andrewrussellmalcolm/LEDClock/hardware/label.png

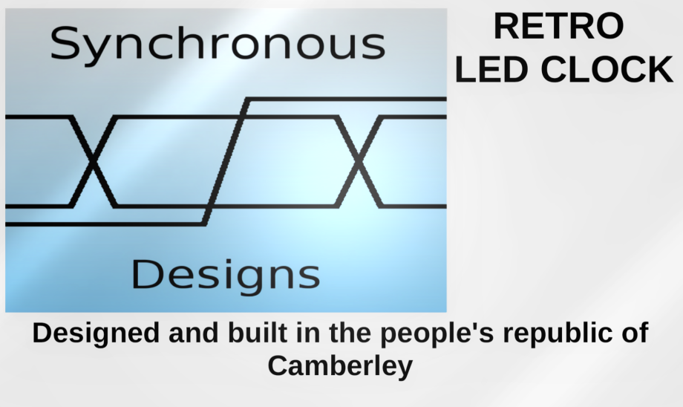
hardware/label.png
