andrewrussellmalcolm/LEDClock/hardware/article/rear-view.png

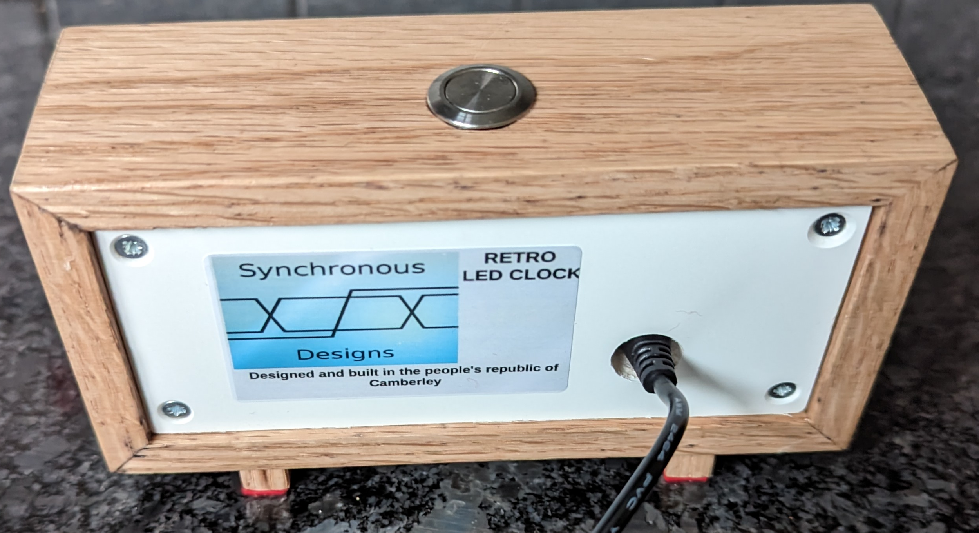
hardware/article/rear-view.png
