andrewrussellmalcolm/LEDClock/hardware/product label.odt

Label Planet LP21/63 | | Label Planet LP21/63 | | Label Planet LP21/63
Label Planet LP21/63 | | Label Planet LP21/63 | | Label Planet LP21/63
Label Planet LP21/63 | | Label Planet LP21/63 | | Label Planet LP21/63
Label Planet LP21/63 | | Label Planet LP21/63 | | Label Planet LP21/63
Label Planet LP21/63 | | Label Planet LP21/63 | | Label Planet LP21/63
Label Planet LP21/63 | | Label Planet LP21/63 | | Label Planet LP21/63
Label Planet LP21/63 | | Label Planet LP21/63 | | Label Planet LP21/63
