andrewrussellmalcolm/LEDClock/hardware/article/3D_model.png

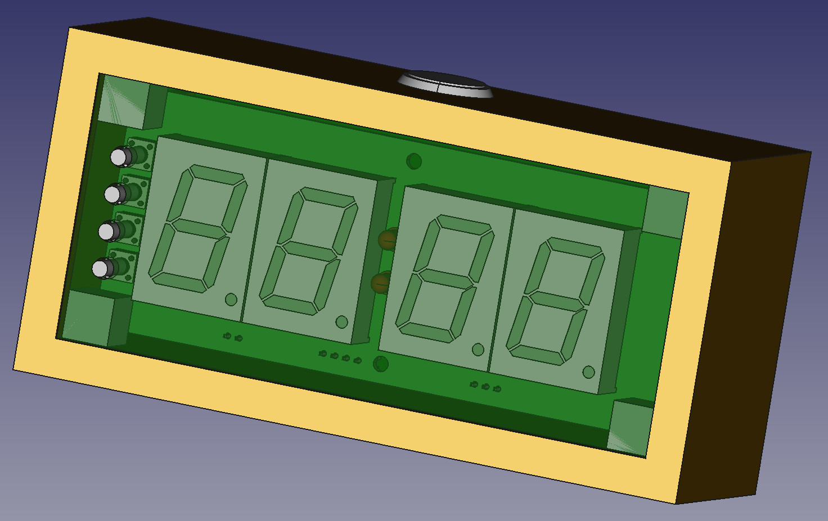
hardware/article/3D_model.png
