andrewrussellmalcolm/LEDClock/hardware/article/front-view.png

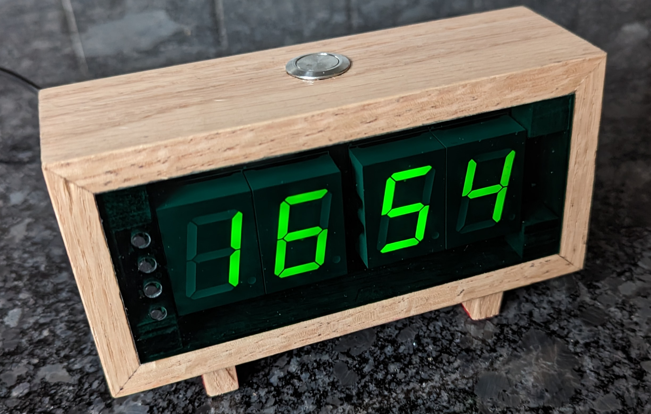
hardware/article/front-view.png
