andrewrussellmalcolm/LEDClock/hardware/article/microcontroller configuration.png

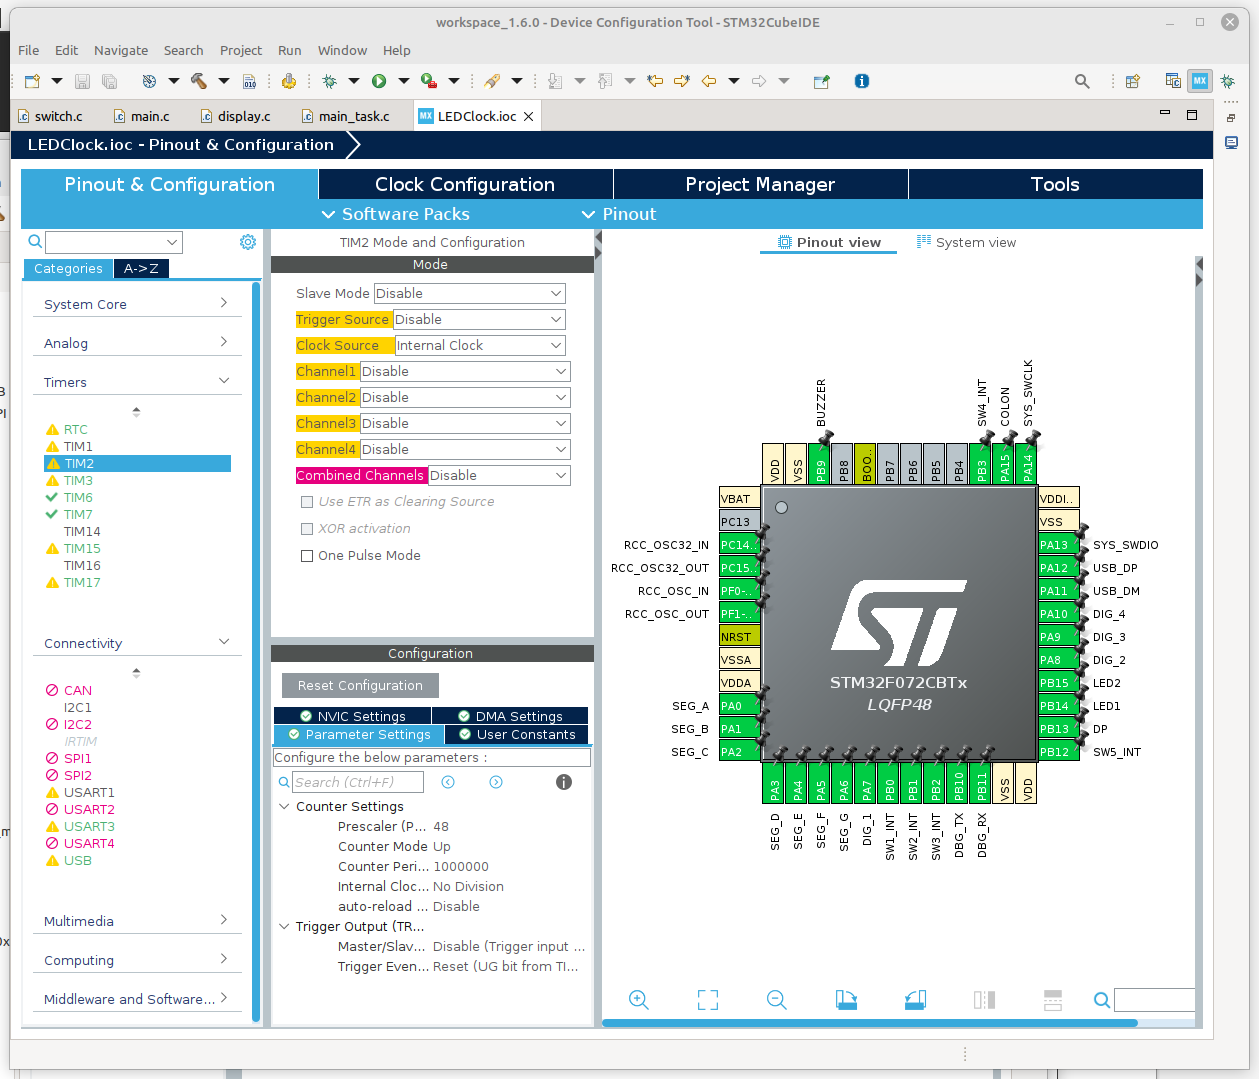
hardware/article/microcontroller configuration.png
