andrewrussellmalcolm/LEDClock/hardware/article/schematic.png

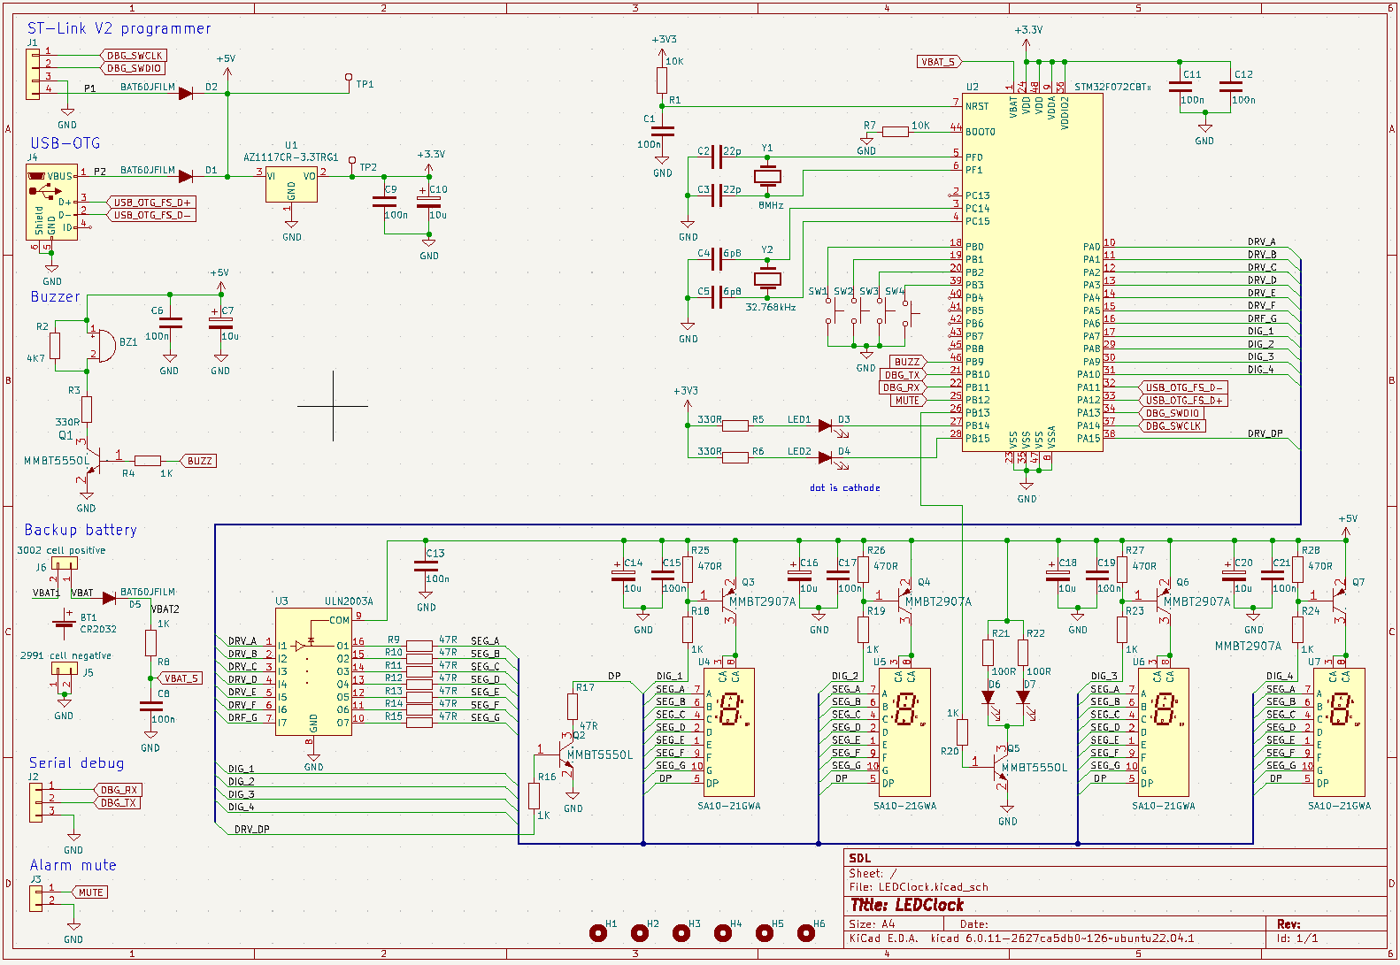
hardware/article/schematic.png
