andrewrussellmalcolm/LEDClock/hardware/LEDClock.jpg

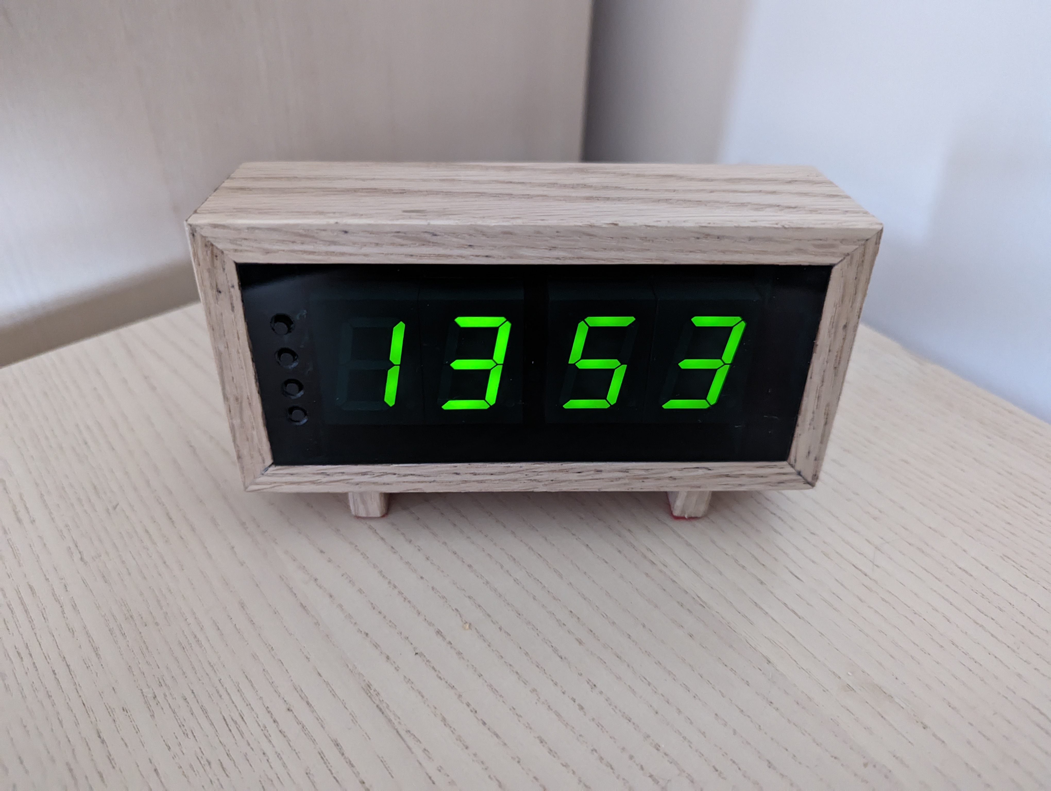
hardware/LEDClock.jpg
