andrewrussellmalcolm/LEDClock/hardware/3D_models/User Library-PKLCS1212E2XXX.STEP

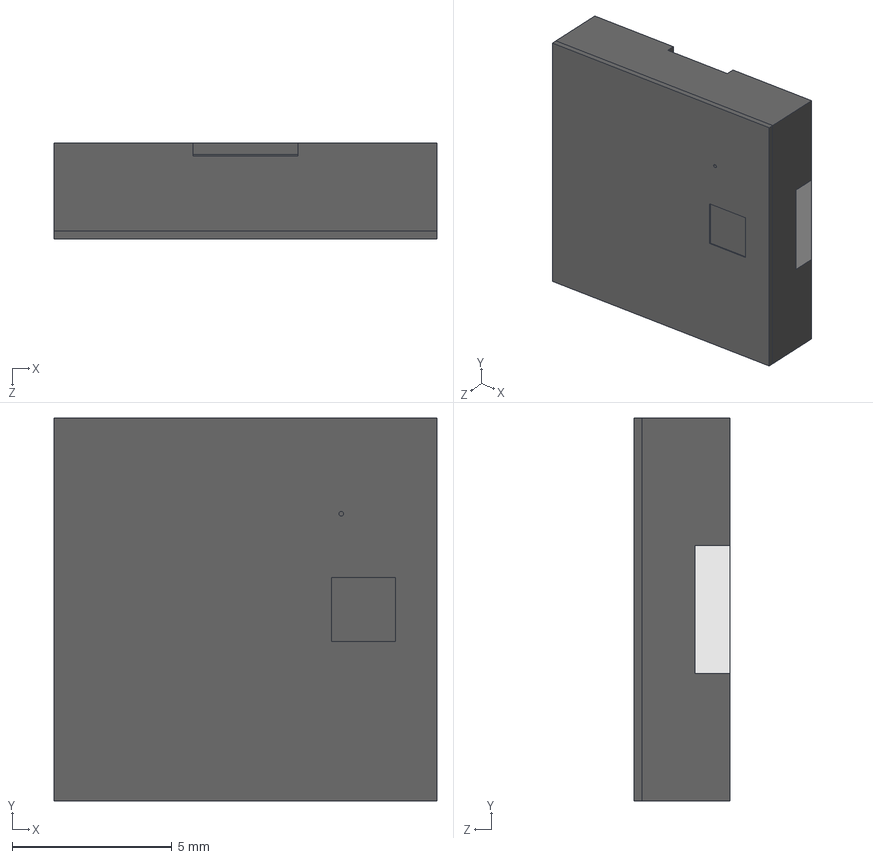
[picture p8: CAD file, 2024-01-20]
hardware/3D_models/User Library-PKLCS1212E2XXX.STEP
12.0 x 12.0 x 3.00 mm
