andrewrussellmalcolm/LEDClock/hardware/3D_models/SA10-21.STEP

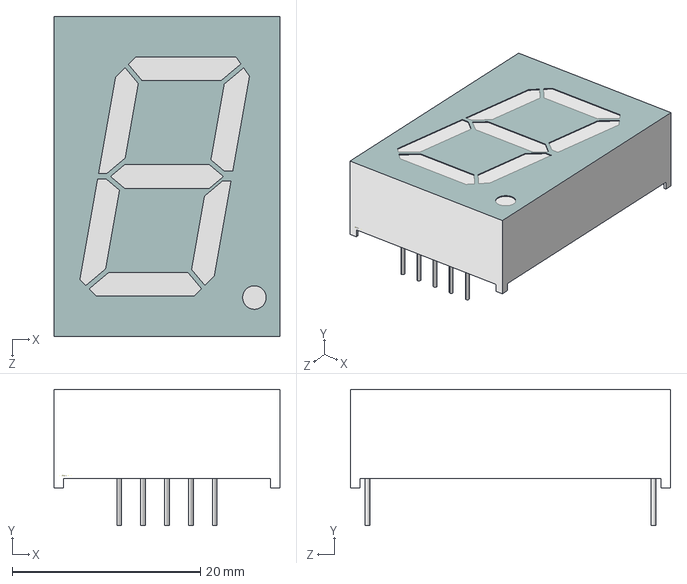
[picture p9: CAD file, 2024-01-20]
hardware/3D_models/SA10-21.STEP
24.0 x 14.5 x 34.0 mm
