andrewrussellmalcolm/LEDClock/hardware/3D_models/User Library-KEYSTONE_2991_Coin_cell_sm_negative_contact.STEP

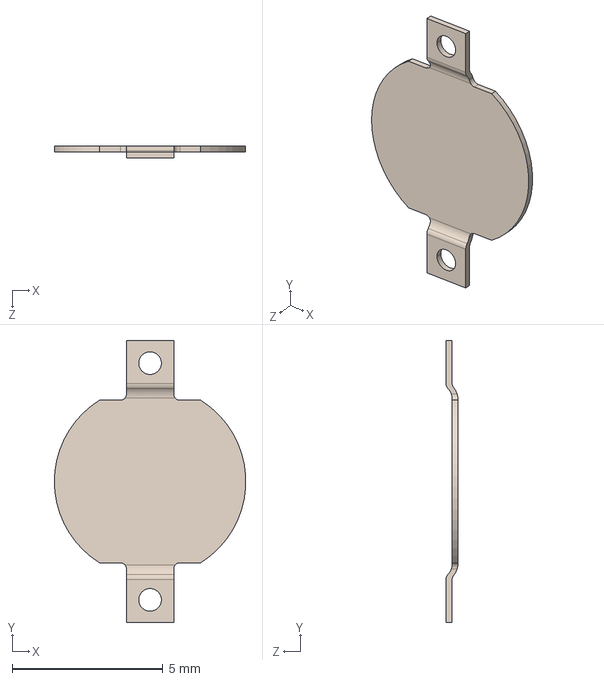
[picture p10: CAD file, 2024-01-20]
hardware/3D_models/User Library-KEYSTONE_2991_Coin_cell_sm_negative_contact.STEP
6.34 x 9.35 x 0.4 mm
