andrewrussellmalcolm/LEDClock/hardware/3D_models/User Library-CR2032 PCB battery holder.STEP

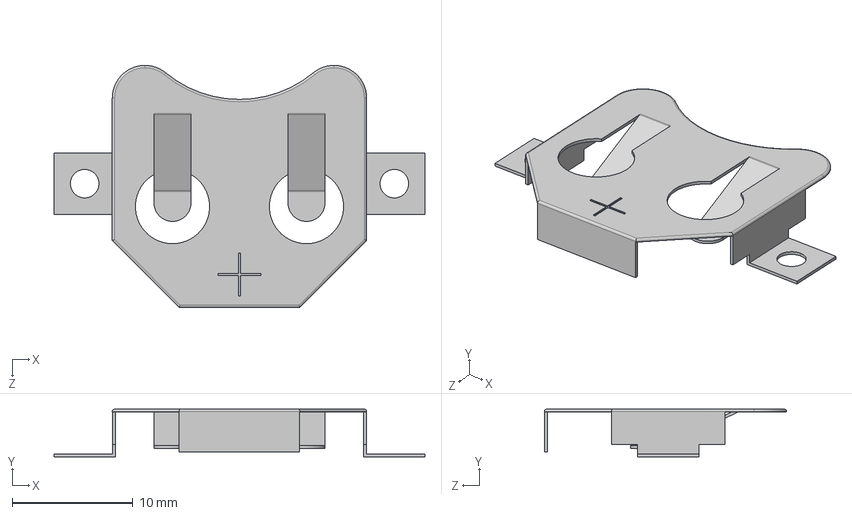
[picture p11: CAD file, 2024-01-20]
hardware/3D_models/User Library-CR2032 PCB battery holder.STEP
30.7 x 3.96 x 20.1 mm
