andrewrussellmalcolm/LEDClock/hardware/3D_models/1051330001.stp

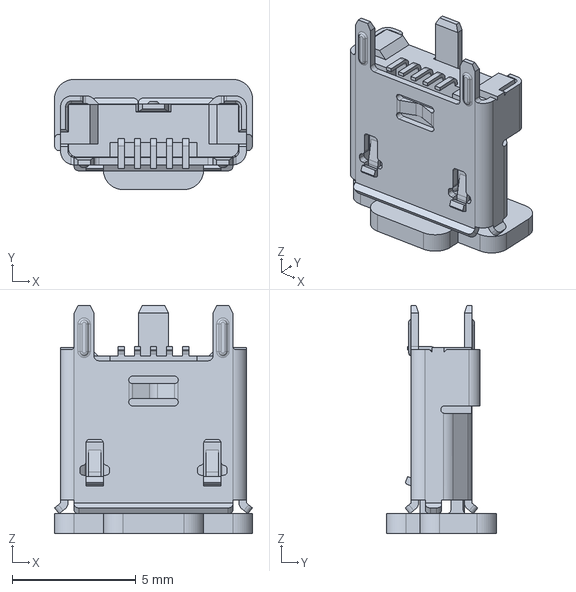
[picture p12: CAD file, 2024-01-20]
hardware/3D_models/1051330001.stp
8.00 x 4.45 x 9.20 mm
