andrewrussellmalcolm/LEDClock/hardware/output.pdf

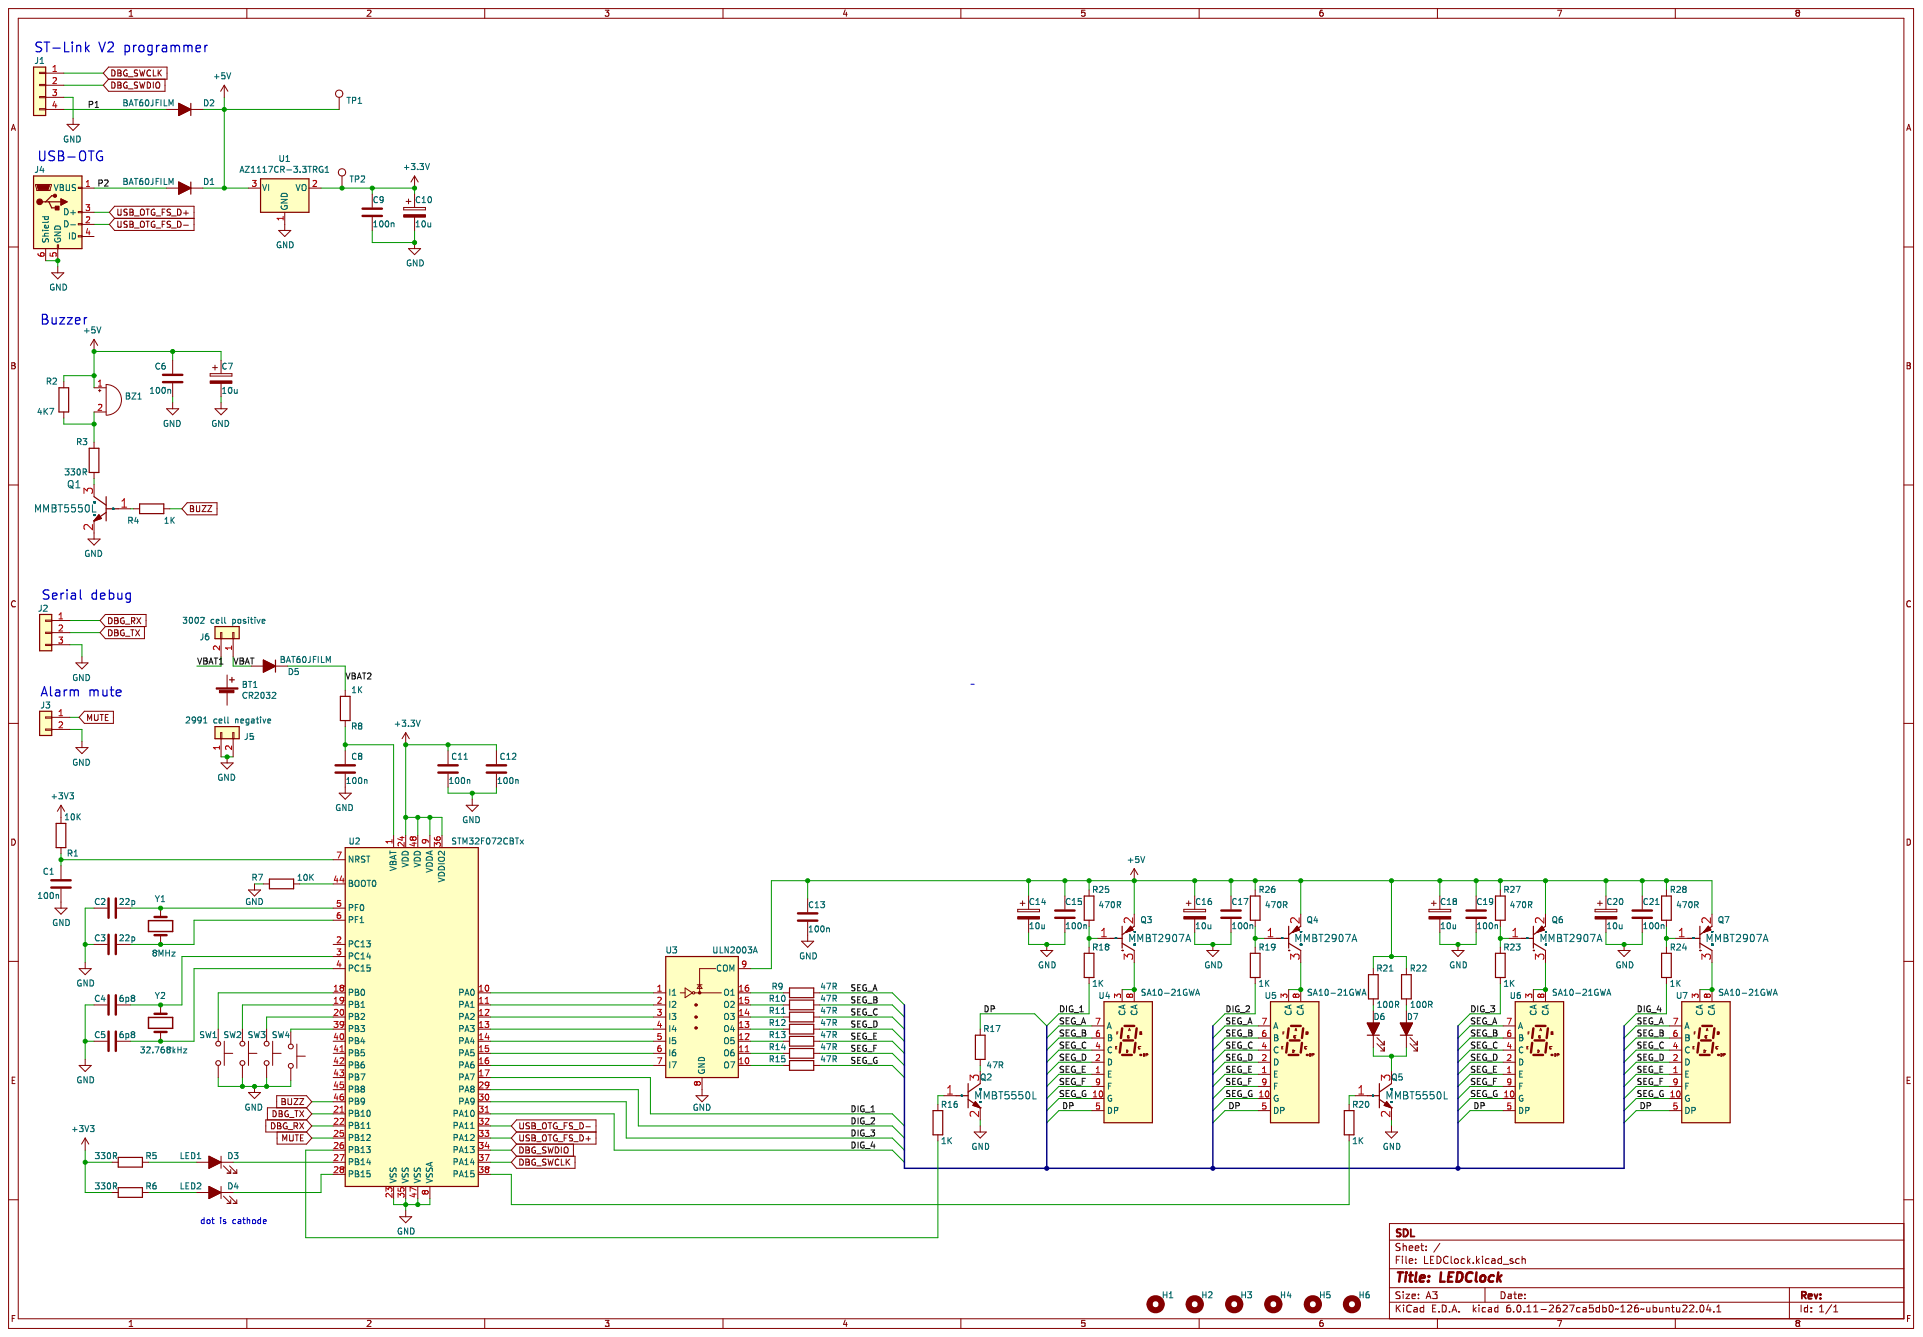
[picture p13: page 1]
