andrewrussellmalcolm/LEDClock/hardware/LEDClock.kicad_pcb

## KiCad design hardware/LEDClock.kicad_pcb (2024-01-20)

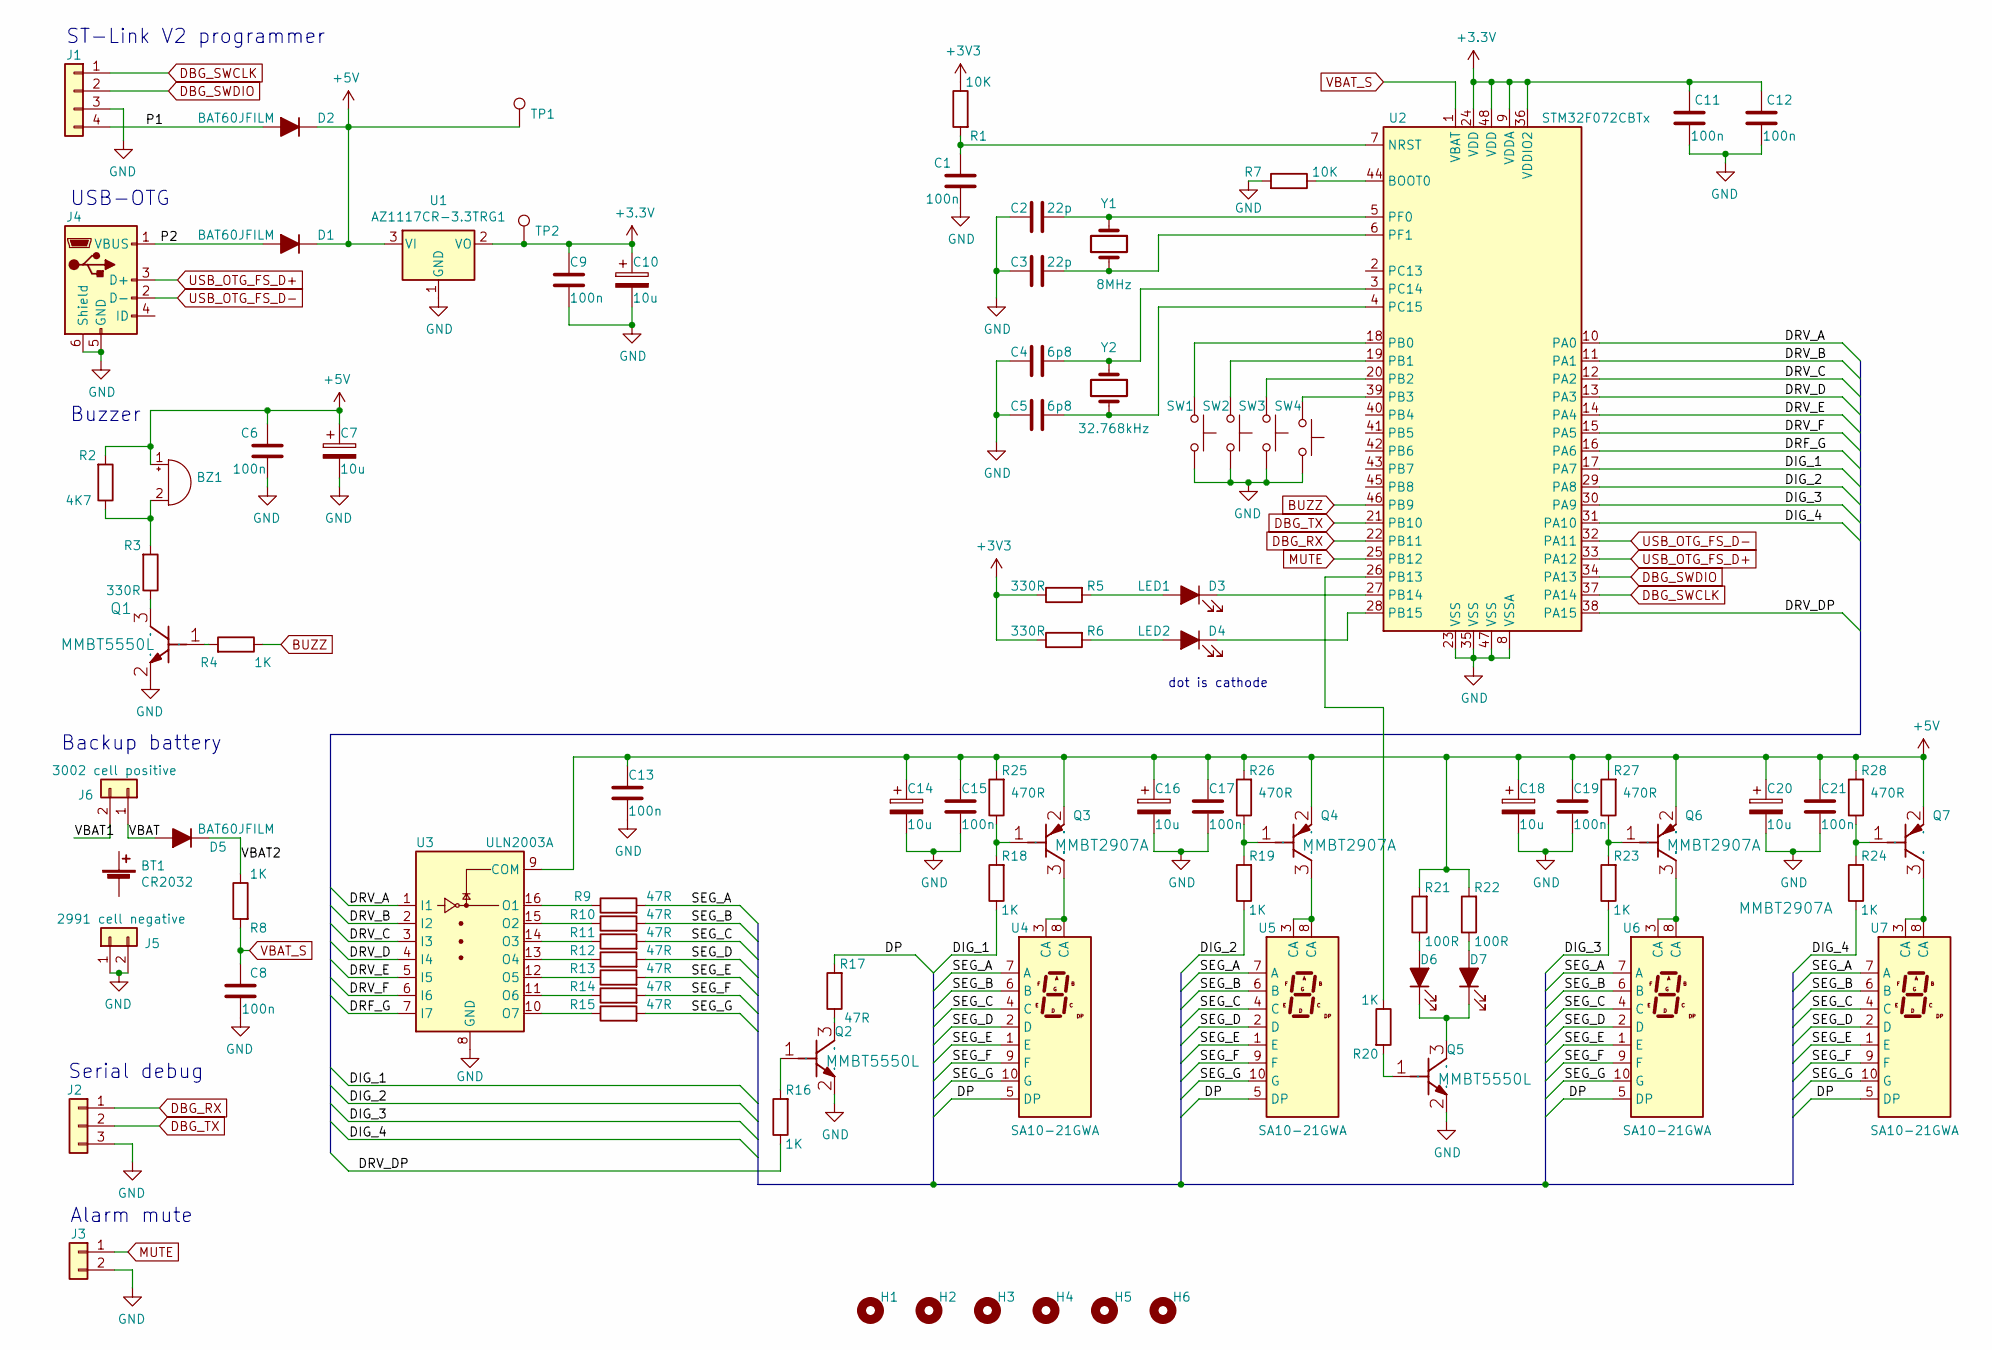
[picture p14: schematic LEDClock.kicad_sch]

Parts:
BT1: CR2032; dummy
BZ1: Buzzer; Buzzer_Murata_PKLCS1212E4001-R1; PartNo PKLCS1212E2000
C1, C8, C11, C12: 100n; C_0603_1608Metric; PartNo C0603C104K3RACTU
C2, C3: 22p; C_0603_1608Metric; PartNo C0603C220J5GACTU
C4, C5: 6p8; C_0603_1608Metric; PartNo C0603C689C5GACTU
C6: 100n; C_0603_1608Metric; Voltage 50V; PartNo C0603C104K4RACTU
C7, C10, C14, C16, C18, C20: 10u; CP_EIA-3216-10_Kemet-I; Voltage 6V3; PartNo TAJR106K006RNJ
C9, C13, C15, C17, C19, C21: 100n; C_0603_1608Metric; Voltage 50V; PartNo C0603C104K3RACTU
D1, D2, D5: BAT60JFILM; D_SOD-323; PartNo BAT60JFILM
D3: LED1; LED_0603_1608Metric; PartNo LS Q976
D4: LED2; LED_0603_1608Metric; PartNo LB Q39E-L2OO-35-1
D6, D7: LED_ALT; LED_D4.0mm; PartNo L-424GDT
H1, H2, H3, H4, H5, H6: MountingHole; MountingHole_3.2mm_M3_ISO7380
J1: Conn_01x04; Molex_KK-254_AE-6410-04A_1x04_P2.54mm_Vertical
J2: Conn_01x03; Molex_KK-254_AE-6410-03A_1x03_P2.54mm_Vertical; PartNo 22-27-2031
J3: Conn_01x02; Molex_KK-254_AE-6410-02A_1x02_P2.54mm_Vertical
J4: USB_B_Micro; USB_Micro-B_Molex-105133-0001
J5: 2991 cell negative; SM_BATTERY_2991_(KEYSTONE)_1; PartNo 2991TR
J6: 3002 cell positive; SM_BATTERY_3002_(KEYSTONE)_1; PartNo 3002TR
Q1: MMBT5550L; SOT-23; PartNo MMBT5550LG
Q2, Q5: MMBT5550L; SOT-23; PartNo MMBT5550L
Q3, Q4, Q6, Q7: MMBT2907A; SOT-23; PartNo MMBT2907A
R1, R7: 10K; R_0603_1608Metric; PartNo CRG0603F10K
R2: 4K7; R_0603_1608Metric; PartNo CRG0603F4K7
R3, R5, R6: 330R; R_0603_1608Metric; PartNo CRG0603F330R
R4: 1K; R_0603_1608Metric; PartNo CRG0603F10K
R8: 1K; R_0603_1608Metric; PartNo CRG0603F1K
R9, R10, R11, R12, R13, R14, R15, R17: 47R; R_0603_1608Metric
R16, R18, R19, R20, R23, R24: 1K; R_0603_1608Metric
R21, R22: 100R; R_0603_1608Metric
R25, R26, R27, R28: 470R; R_0603_1608Metric
SW1, SW2, SW3, SW4: SW_Push; SW_PUSH_6mm_H5mm
TP1, TP2: TestPoint-Connector; TestPoint_Pad_D1.0mm
U1: AZ1117CR-3.3TRG1; SOT-89-3
U2: STM32F072CBTx; LQFP-48_7x7mm_P0.5mm
U3: ULN2003A; SO-16_3.9x9.9mm_P1.27mm
U4, U5, U6, U7: SA10-21GWA; SA10-21xxx
Y1: 8MHz; Crystal_SMD_5032-2Pin_5.0x3.2mm; PartNo 144-5033
Y2: 32.768kHz; Crystal_SMD_2012-2Pin_2.0x1.2mm; PartNo X1A000061000212

Connections:
+5V: BZ1.1 (-), C6.2, C7.1, C13.1, C14.1, C15.1, C16.1, C17.1, C18.1, C19.1, C20.1, C21.1, D1.1 (K), D2.1 (K), Q3.2 (EMITTER), Q4.2 (EMITTER), Q6.2 (EMITTER), Q7.2 (EMITTER), R2.2, R21.2, R22.2, R25.2, R26.2, R27.2, R28.2, TP1.1, U1.3 (VI), U3.9 (COM)
/DIG_1: R18.1, U2.17 (PA7)
/DIG_2: R19.1, U2.29 (PA8)
/DIG_3: R23.1, U2.30 (PA9)
/DIG_4: R24.1, U2.31 (PA10)
/DP: R17.2, U4.5 (DP), U5.5 (DP), U6.5 (DP), U7.5 (DP)
/P1: D2.2 (A), J1.4
/P2: D1.2 (A), J4.1 (VBUS)
/SEG_A: R9.2, U4.7 (A), U5.7 (A), U6.7 (A), U7.7 (A)
/SEG_B: R10.2, U4.6 (B), U5.6 (B), U6.6 (B), U7.6 (B)
/SEG_C: R11.2, U4.4 (C), U5.4 (C), U6.4 (C), U7.4 (C)
/SEG_D: R12.2, U4.2 (D), U5.2 (D), U6.2 (D), U7.2 (D)
/SEG_E: R13.2, U4.1 (E), U5.1 (E), U6.1 (E), U7.1 (E)
/SEG_F: R14.2, U4.9 (F), U5.9 (F), U6.9 (F), U7.9 (F)
/SEG_G: R15.2, U4.10 (G), U5.10 (G), U6.10 (G), U7.10 (G)
/VBAT: D5.2 (A), J6.1
/VBAT1: J6.2
/VBAT2: D5.1 (K), R8.1
BUZZ: R4.1, U2.46 (PB9)
DBG_RX: J2.1, U2.22 (PB11)
DBG_SWCLK: J1.1, U2.37 (PA14)
DBG_SWDIO: J1.2, U2.34 (PA13)
DBG_TX: J2.2, U2.21 (PB10)
GND: C1.1, C2.2, C3.2, C4.2, C5.2, C6.1, C7.2, C8.1, C9.2, C10.2, C11.1, C12.1, C13.2, C14.2, C15.2, C16.2, C17.2, C18.2, C19.2, C20.2, C21.2, J1.3, J2.3, J3.2, J4.5 (GND), J4.6 (Shield), J5.1, J5.2, Q1.2 (EMITTER), Q2.2 (EMITTER), Q5.2 (EMITTER), R7.2, SW1.1, SW2.1, SW3.1, SW4.1, U1.1 (GND), U2.8 (VSSA), U2.23 (VSS), U2.35 (VSS), U2.47 (VSS), U3.8 (GND)
MUTE: J3.1, U2.25 (PB12)
unnamed: BZ1.2 (+), R2.1, R3.2
unnamed: C1.2, R1.2, U2.7 (NRST)
unnamed: C2.1, U2.5 (PF0), Y1.1
unnamed: C3.1, U2.6 (PF1), Y1.2
unnamed: C4.1, U2.3 (PC14), Y2.1
unnamed: C5.1, U2.4 (PC15), Y2.2
unnamed: C8.2, R8.2, U2.1 (VBAT)
unnamed: D3.1 (K), U2.27 (PB14)
unnamed: D3.2 (A), R5.2
unnamed: D4.1 (K), U2.28 (PB15)
unnamed: D4.2 (A), R6.2
unnamed: D6.1 (K), D7.1 (K), Q5.3 (COLLECTOR)
unnamed: D6.2 (A), R21.1
unnamed: D7.2 (A), R22.1
unnamed: Q1.1 (BASE), R4.2
unnamed: Q1.3 (COLLECTOR), R3.1
unnamed: Q2.1 (BASE), R16.2
unnamed: Q2.3 (COLLECTOR), R17.1
unnamed: Q3.1 (BASE), R18.2, R25.1
unnamed: Q3.3 (COLLECTOR), U4.3 (CA), U4.8 (CA)
unnamed: Q4.1 (BASE), R19.2, R26.1
unnamed: Q4.3 (COLLECTOR), U5.3 (CA), U5.8 (CA)
unnamed: Q5.1 (BASE), R20.2
unnamed: Q6.1 (BASE), R23.2, R27.1
unnamed: Q6.3 (COLLECTOR), U6.3 (CA), U6.8 (CA)
unnamed: Q7.1 (BASE), R24.2, R28.1
unnamed: Q7.3 (COLLECTOR), U7.3 (CA), U7.8 (CA)
unnamed: R7.1, U2.44 (BOOT0)
unnamed: R9.1, U3.16 (O1)
unnamed: R10.1, U3.15 (O2)
unnamed: R11.1, U3.14 (O3)
unnamed: R12.1, U3.13 (O4)
unnamed: R13.1, U3.12 (O5)
unnamed: R14.1, U3.11 (O6)
unnamed: R15.1, U3.10 (O7)
unnamed: SW1.2, U2.18 (PB0)
unnamed: SW2.2, U2.19 (PB1)
unnamed: SW3.2, U2.20 (PB2)
unnamed: SW4.2, U2.39 (PB3)
unnamed: U2.10 (PA0), U3.1 (I1)
unnamed: U2.11 (PA1), U3.2 (I2)
unnamed: U2.12 (PA2), U3.3 (I3)
unnamed: U2.13 (PA3), U3.4 (I4)
unnamed: U2.14 (PA4), U3.5 (I5)
unnamed: U2.15 (PA5), U3.6 (I6)
unnamed: U2.16 (PA6), U3.7 (I7)
USB_OTG_FS_D+: J4.3 (D+), U2.33 (PA12)
USB_OTG_FS_D-: J4.2 (D-), U2.32 (PA11)

Notes on the sheet:
Backup battery
Alarm mute
Buzzer
USB-OTG
ST-Link V2 programmer
dot is cathode
Serial debug

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
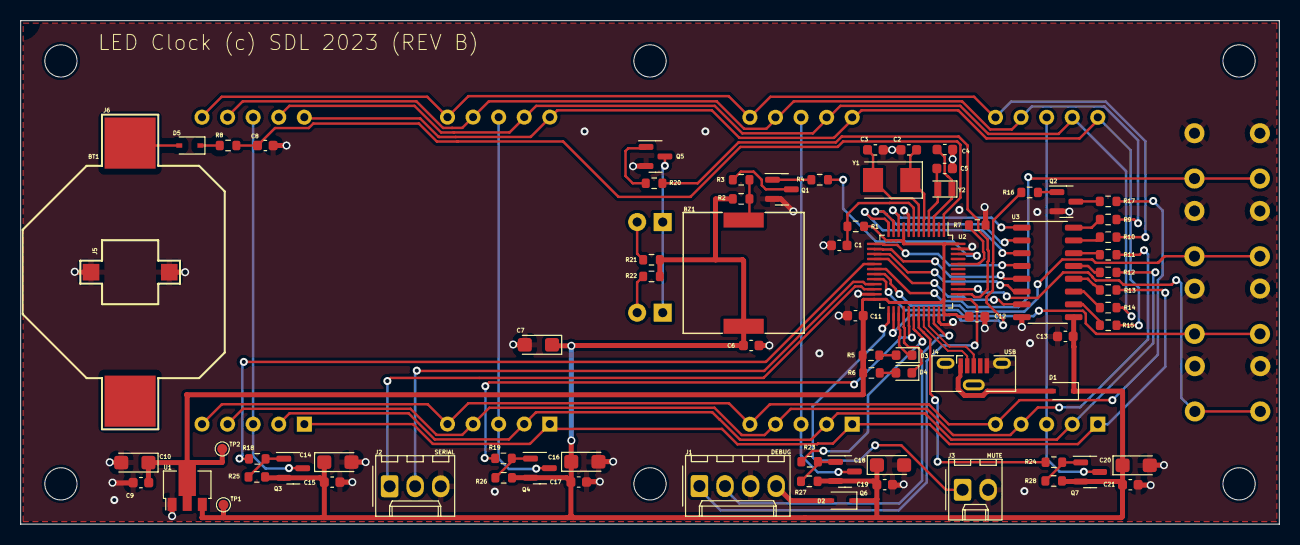
[picture p15: board LEDClock.kicad_pcb from above]

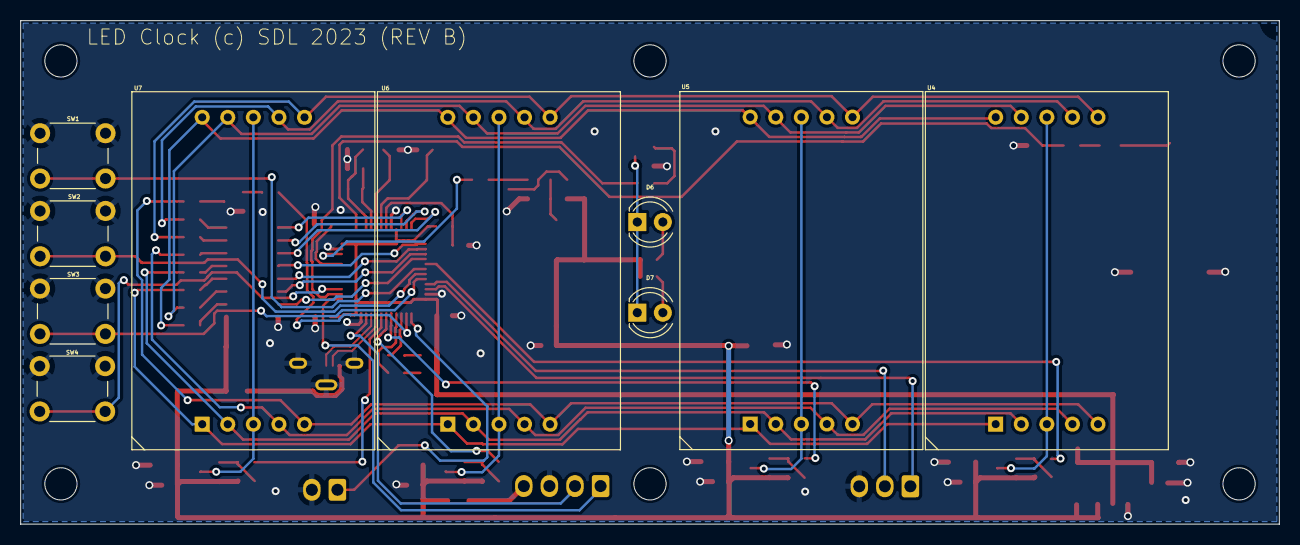
[picture p16: board LEDClock.kicad_pcb from below]

Board: 2 copper layers, 125.0 x 50.0 mm, 92 parts (10 on the bottom side), 75 nets.
