andrewrussellmalcolm/LEDClock/firmware/Core/Src/main.c

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
/* Includes ------------------------------------------------------------------*/
#include "main.h"
#include "usb_device.h"

/* USER CODE BEGIN PD */
extern void main_task(void);
/* USER CODE END PD */

RTC_HandleTypeDef hrtc;

TIM_HandleTypeDef htim2;
TIM_HandleTypeDef htim3;
TIM_HandleTypeDef htim6;
TIM_HandleTypeDef htim7;
TIM_HandleTypeDef htim15;
TIM_HandleTypeDef htim17;

UART_HandleTypeDef huart3;

void SystemClock_Config(void);
static void MX_GPIO_Init(void);
static void MX_RTC_Init(void);
static void MX_TIM17_Init(void);
static void MX_USART3_UART_Init(void);
static void MX_TIM2_Init(void);
static void MX_TIM3_Init(void);
static void MX_TIM7_Init(void);
static void MX_TIM6_Init(void);
static void MX_TIM15_Init(void);
/* USER CODE BEGIN 0 */
#include <stdio.h>
#include <sys/unistd.h>
#include "usbd_def.h"
#include "usbd_core.h"
#include "usbd_cdc_if.h"

// read from usb serial port
int _read(int file, char *data, int len)
{
	while(!usb_char_waiting())
	{
		HAL_Delay(10);
	}

    *data = usb_read_char();
	return 1;
}

// write to usb serial port
int _write(int file, char *ptr, int len)
{
	if(usb_is_configured())
	{
		usb_write_chars(ptr, len);
	}

	return len;
}
/* USER CODE END 0 */

/**
  * @brief  The application entry point.
  * @retval int
  */
int main(void)
{
  /* MCU Configuration--------------------------------------------------------*/

  /* Reset of all peripherals, Initializes the Flash interface and the Systick. */
  HAL_Init();

  /* Configure the system clock */
  SystemClock_Config();

  /* Initialize all configured peripherals */
  MX_GPIO_Init();
  MX_RTC_Init();
  MX_TIM17_Init();
  MX_USART3_UART_Init();
  MX_TIM2_Init();
  MX_TIM3_Init();
  MX_TIM7_Init();
  MX_USB_DEVICE_Init();
  MX_TIM6_Init();
  MX_TIM15_Init();
  /* USER CODE BEGIN 2 */
  setvbuf(stdin, NULL, _IONBF, 0);
  setvbuf(stdout, NULL, _IONBF, 0);
  setvbuf(stderr, NULL, _IONBF, 0);

  /* USER CODE END 2 */

  /* Infinite loop */
  /* USER CODE BEGIN WHILE */
  while (1)
  {
	  for(int delay =0; delay < 50; delay++)
	  {
			if(usb_is_configured())
			{
				break;
			}
			HAL_Delay(100);
	  }
	  main_task();
    /* USER CODE END WHILE */

    /* USER CODE BEGIN 3 */
  }
  /* USER CODE END 3 */
}

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
